soldout-12/Balance_Car/img/2e5a75ae707d3b0441587012e2fe5ee4.jpg

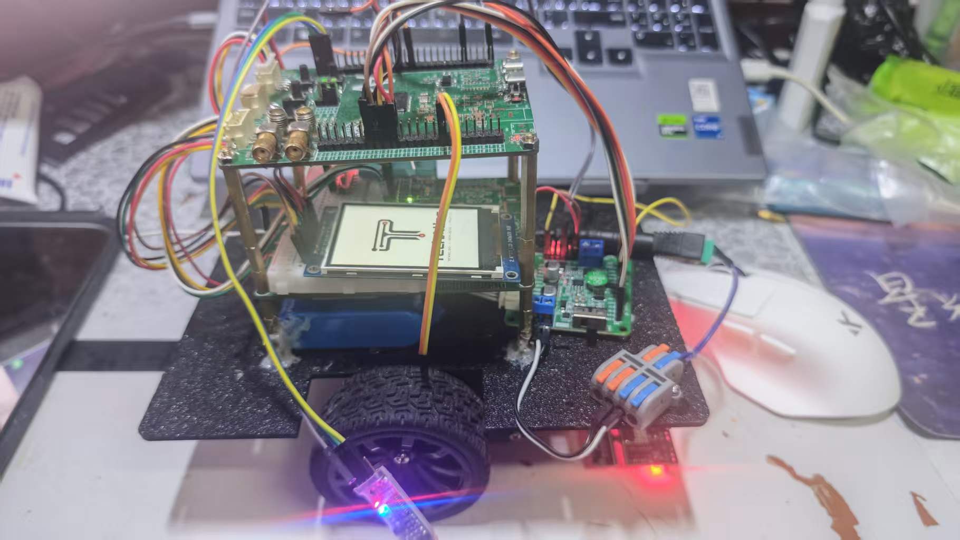
img/2e5a75ae707d3b0441587012e2fe5ee4.jpg
