soldout-12/Balance_Car/img/传感器特写.jpg

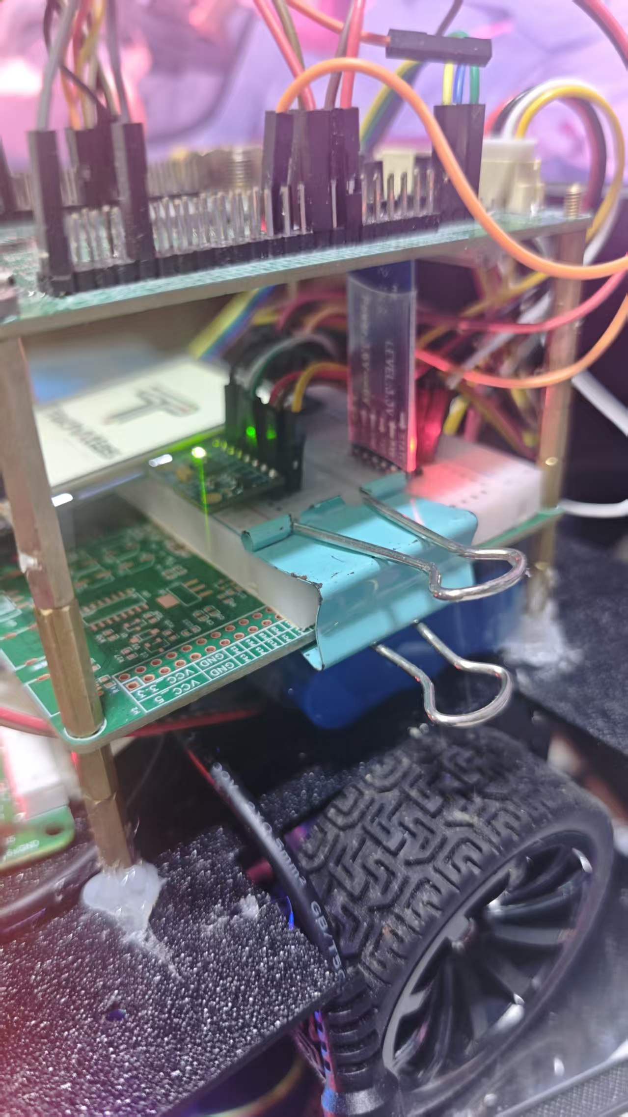
img/传感器特写.jpg
