soldout-12/Balance_Car/img/侧视1.jpg

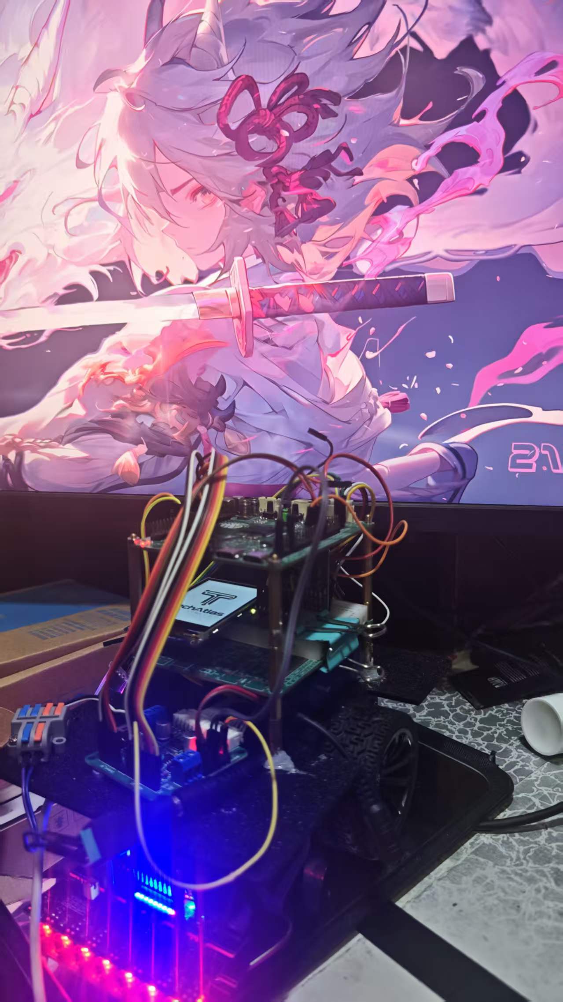
img/侧视1.jpg
