soldout-12/Balance_Car/balance_car.ioc

Mcu.UserName=STM32F103VETx
PA10.GPIO_Label=AIN1
PA10.Signal=GPIO_Output
PA11.GPIO_Label=AIN2
PA11.Signal=GPIO_Output
PA13.Signal=SYS_JTMS-SWDIO
PA14.Signal=SYS_JTCK-SWCLK
PA15.GPIO_Label=LCD_CS
PA15.Signal=GPIO_Output
PA2.Signal=USART2_TX
PA3.Signal=USART2_RX
PA6.Signal=S_TIM3_CH1
PA7.Signal=S_TIM3_CH2
PA8.Signal=S_TIM1_CH1
PA9.Signal=S_TIM1_CH2
PB0.GPIO_Label=LCD_DC
PB0.Signal=GPIO_Output
PB1.GPIO_Label=LCD_RST
PB1.Signal=GPIO_Output
PB12.GPIO_Label=MPU_INT
PB12.Signal=GPIO_Input
PB13.GPIO_Label=MPU_AD0
PB13.Signal=GPIO_Output
PB14.GPIO_Label=IIC1_SDA
PB14.Signal=GPIO_Output
PB15.GPIO_Label=IIC1_SCL
PB15.Signal=GPIO_Output
PB3.Signal=SPI1_SCK
PB4.Signal=SPI1_MISO
PB5.Signal=SPI1_MOSI
PB8.Signal=GPIO_Output
PC6.Signal=S_TIM8_CH1
PC7.Signal=S_TIM8_CH2
PC8.GPIO_Label=BIN1
PC8.Signal=GPIO_Output
PC9.GPIO_Label=BIN2
PC9.Signal=GPIO_Output
PD3.GPIO_Label=IIC2_SDA
PD3.Signal=GPIO_Output
PD4.GPIO_Label=IIC2_SCL
PD4.Signal=GPIO_Output
PE13.Signal=GPXTI13
