soldout-12/Balance_Car/Core/Inc/main.h

#define LCD_DC_Pin GPIO_PIN_0
#define LCD_DC_GPIO_Port GPIOB
#define LCD_RST_Pin GPIO_PIN_1
#define LCD_RST_GPIO_Port GPIOB
#define MPU_INT_Pin GPIO_PIN_12
#define MPU_INT_GPIO_Port GPIOB
#define MPU_AD0_Pin GPIO_PIN_13
#define MPU_AD0_GPIO_Port GPIOB
#define IIC1_SDA_Pin GPIO_PIN_14
#define IIC1_SDA_GPIO_Port GPIOB
#define IIC1_SCL_Pin GPIO_PIN_15
#define IIC1_SCL_GPIO_Port GPIOB
#define BIN1_Pin GPIO_PIN_8
#define BIN1_GPIO_Port GPIOC
#define BIN2_Pin GPIO_PIN_9
#define BIN2_GPIO_Port GPIOC
#define AIN1_Pin GPIO_PIN_10
#define AIN1_GPIO_Port GPIOA
#define AIN2_Pin GPIO_PIN_11
#define AIN2_GPIO_Port GPIOA
#define LCD_CS_Pin GPIO_PIN_15
#define LCD_CS_GPIO_Port GPIOA
#define IIC2_SDA_Pin GPIO_PIN_3
#define IIC2_SDA_GPIO_Port GPIOD
#define IIC2_SCL_Pin GPIO_PIN_4
#define IIC2_SCL_GPIO_Port GPIOD
